casten/cnixxi/nixietest2/nixietest2.kicad_pcb

## KiCad design nixietest2/nixietest2.kicad_pcb (2023-05-30)

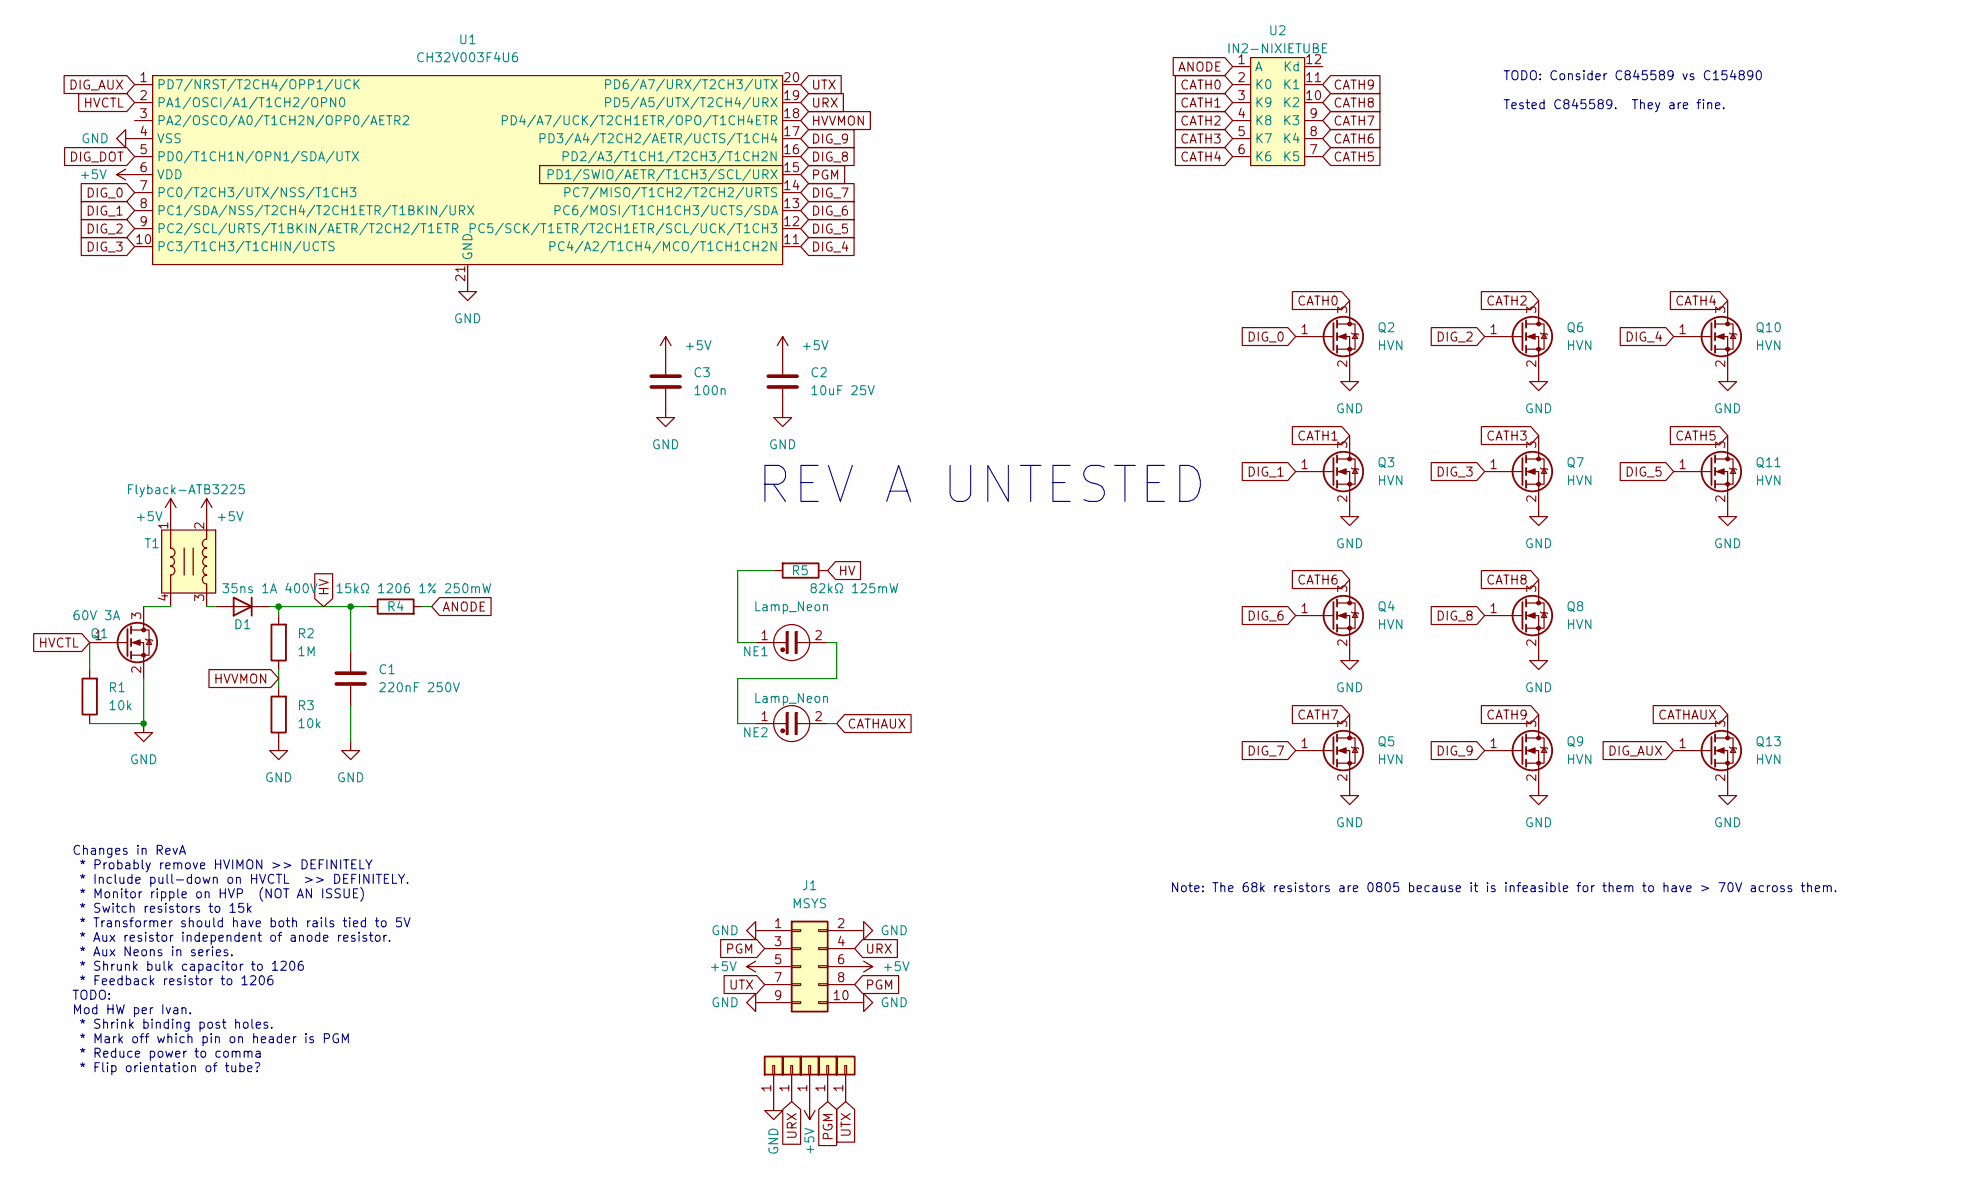
[picture p2: schematic nixietest2.kicad_sch]

Parts:
C1: 220nF 250V; C_1206_3216Metric; LCSC C377089
C2: 10uF 25V; C_0603_1608Metric; LCSC C96446
C3: 100n; C_0402_1005Metric; LCSC C1525
D1: 35ns 1A 400V; D_SOD-123F; LCSC C128697
J1: MSYS; PinHeader_2x05_P2.54mm_Horizontal; LCSC C239336
J2, J3, J4, J5, J6: rawpad22
NE1, NE2: Lamp_Neon; neonglow
Q1: 60V 3A; SOT-23; LCSC C2938374
Q2, Q3, Q4, Q5, Q6, Q7, Q8, Q9, Q10, Q11, Q13: HVN; SOT-23; LCSC C845589
R1, R3: 10k; R_0402_1005Metric; LCSC C25744
R2: 1M; R_1206_3216Metric; LCSC C108083
R4: 15kΩ 1206 1% 250mW; R_1206_3216Metric; LCSC C114932
R5: 82kΩ 125mW; R_0805_2012Metric; LCSC C136904
T1: Flyback-ATB3225; LCSC C415291
U1: CH32V003F4U6; QFN-20-1EP_3x3mm_P0.4mm_EP1.65x1.65mm; LCSC C5299908
U2: IN2-NIXIETUBE; IN12-NIXIE

Connections:
+5V: C2.1, C3.1, J1.5, J1.6, J3.1, T1.1, T1.2, U1.6 (VDD)
ANODE: R4.2, U2.1 (A)
CATH0: Q2.3 (D), U2.2 (K0)
CATH1: Q3.3 (D), U2.3 (K9)
CATH2: Q6.3 (D), U2.4 (K8)
CATH3: Q7.3 (D), U2.5 (K7)
CATH4: Q10.3 (D), U2.6 (K6)
CATH5: Q11.3 (D), U2.7 (K5)
CATH6: Q4.3 (D), U2.8 (K4)
CATH7: Q5.3 (D), U2.9 (K3)
CATH8: Q8.3 (D), U2.10 (K2)
CATH9: Q9.3 (D), U2.11 (K1)
CATHAUX: NE2.2, Q13.3 (D)
DIG_0: Q2.1 (G), U1.7 (PC0/T2CH3/UTX/NSS/T1CH3)
DIG_1: Q3.1 (G), U1.8 (PC1/SDA/NSS/T2CH4/T2CH1ETR/T1BKIN/URX)
DIG_2: Q6.1 (G), U1.9 (PC2/SCL/URTS/T1BKIN/AETR/T2CH2/T1ETR)
DIG_3: Q7.1 (G), U1.10 (PC3/T1CH3/T1CHIN/UCTS)
DIG_4: Q10.1 (G), U1.11 (PC4/A2/T1CH4/MCO/T1CH1CH2N)
DIG_5: Q11.1 (G), U1.12 (PC5/SCK/T1ETR/T2CH1ETR/SCL/UCK/T1CH3)
DIG_6: Q4.1 (G), U1.13 (PC6/MOSI/T1CH1CH3/UCTS/SDA)
DIG_7: Q5.1 (G), U1.14 (PC7/MISO/T1CH2/T2CH2/URTS)
DIG_8: Q8.1 (G), U1.16 (PD2/A3/T1CH1/T2CH3/T1CH2N)
DIG_9: Q9.1 (G), U1.17 (PD3/A4/T2CH2/AETR/UCTS/T1CH4)
DIG_AUX: Q13.1 (G), U1.1 (PD7/NRST/T2CH4/OPP1/UCK)
DIG_DOT: U1.5 (PD0/T1CH1N/OPN1/SDA/UTX); also elsewhere on the board
GND: C1.2, C2.2, C3.2, J1.1, J1.2, J1.9, J1.10, J2.1, Q1.2 (S), Q2.2 (S), Q3.2 (S), Q4.2 (S), Q5.2 (S), Q6.2 (S), Q7.2 (S), Q8.2 (S), Q9.2 (S), Q10.2 (S), Q11.2 (S), Q13.2 (S), R1.1, R3.1, U1.4 (VSS), U1.21 (GND); also elsewhere on the board
HV: C1.1, D1.1 (K), R2.2, R4.1, R5.1
HVCTL: Q1.1 (G), R1.2, U1.2 (PA1/OSCI/A1/T1CH2/OPN0)
HVVMON: R2.1, R3.2, U1.18 (PD4/A7/UCK/T2CH1ETR/OPO/T1CH4ETR)
unnamed: D1.2 (A), T1.3
unnamed: NE1.1, R5.2
unnamed: NE1.2, NE2.1
unnamed: Q1.3 (D), T1.4
PGM: J1.3, J1.8, J5.1, U1.15 (PD1/SWIO/AETR/T1CH3/SCL/URX)
URX: J1.4, J4.1, U1.19 (PD5/A5/UTX/T2CH4/URX)
UTX: J1.7, J6.1, U1.20 (PD6/A7/URX/T2CH3/UTX)

Notes on the sheet:
TODO: Consider C845589 vs C154890 Tested C845589. They are fine.
Changes in RevA * Probably remove HVIMON >> DEFINITELY * Include pull-down on HVCTL >> DEFINITELY. * Monitor ripple on HVP (NOT AN ISSUE) * Switch resistors to 15k * Transformer should have both rails tied to 5V * Aux resistor independent of anode resistor. * Aux Neons in series. * Shrunk bulk capa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
REV A UNTESTED
Note: The 68k resistors are 0805 because it is infeasible for them to have > 70V across them.

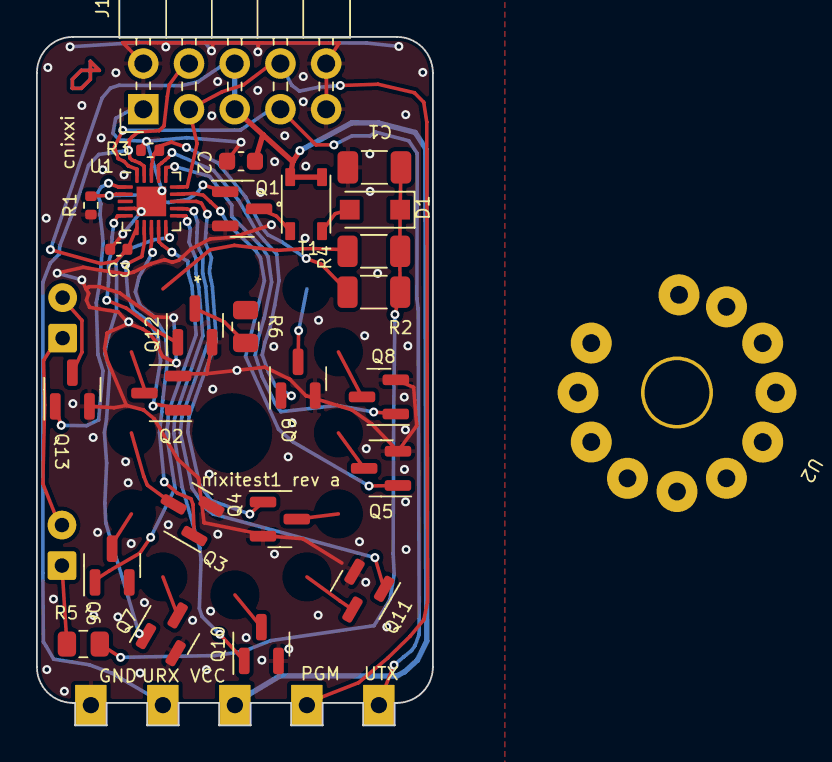
[picture p3: board nixietest2.kicad_pcb from above]

Board: 2 copper layers, 22.0 x 38.2 mm, 34 parts (0 on the bottom side), 37 nets.

Other parts of the board:
Q12: HVN; SOT-23
R6: 82kΩ 125mW; R_0805_2012Metric

Their connections:
DIG_DOT: Q12.1 (G); also elsewhere on the board
GND: Q12.2 (S); also elsewhere on the board
unnamed: Q12.3 (D), R6.2
